JoshLongmire/Weather-Station-1-ESP32/THIRD_PARTY_LICENSES.md

# Third‑Party Licenses

Project license: PolyForm Noncommercial 1.0.0 (see `LICENSE`).
Docs and images: CC BY‑4.0 (see `LICENSE-CC-BY-4.0.md`).

This project uses the following third‑party libraries. Their original LICENSE files are kept with the libraries in your Arduino libraries directory and/or upstream repositories. Below is a summary for convenience; always refer to the original LICENSE files for the binding terms.

- Sensirion SCD4x Arduino driver (SCD40/SCD41)
  - Upstream: Sensirion AG
  - License: BSD‑3‑Clause
  - Notes: We retain license headers in any copied example code and do not remove or alter them.

- Adafruit BME680 Library
  - Upstream: Adafruit Industries
  - License: BSD

- Adafruit Unified Sensor
  - Upstream: Adafruit Industries
  - License: BSD

- Adafruit VEML7700 Library
  - Upstream: Adafruit Industries
  - License: BSD

- RTClib
  - Upstream: Adafruit/Jeelab contributors
  - License: MIT

- ArduinoJson
  - Upstream: Benoit Blanchon
  - License: MIT

- ElegantOTA
  - Upstream: Ayush Sharma
  - License: MIT

- Arduino‑ESP32 Core
  - Upstream: Espressif Systems
  - License: Apache‑2.0
