JoshLongmire/Weather-Station-1-ESP32/docs/Configsettingspage.png

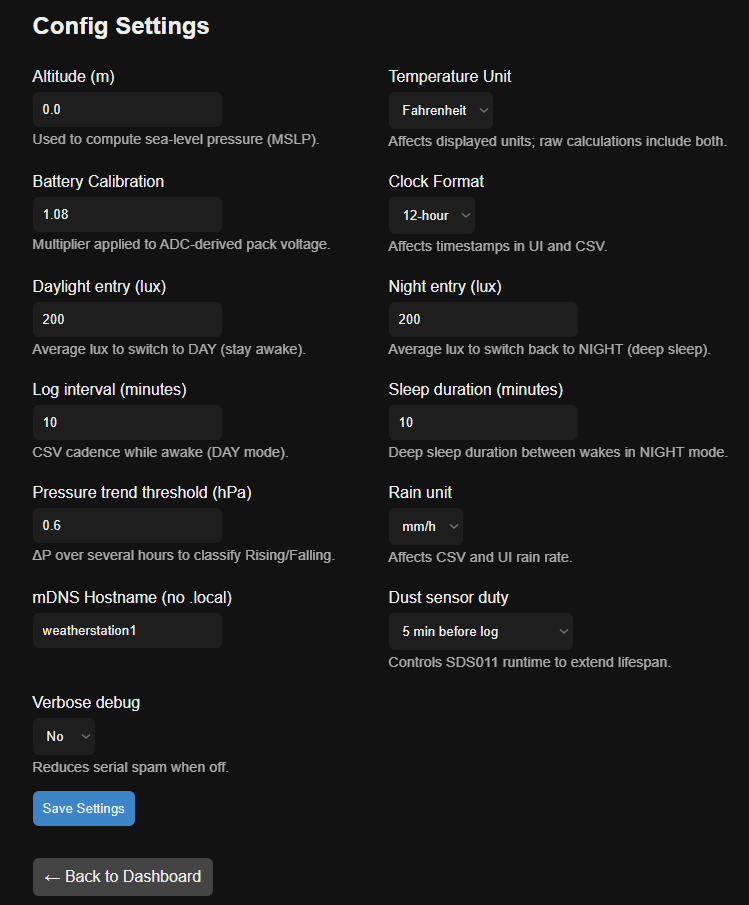
docs/Configsettingspage.png
