JoshLongmire/Weather-Station-1-ESP32/docs/Mainpage1.png

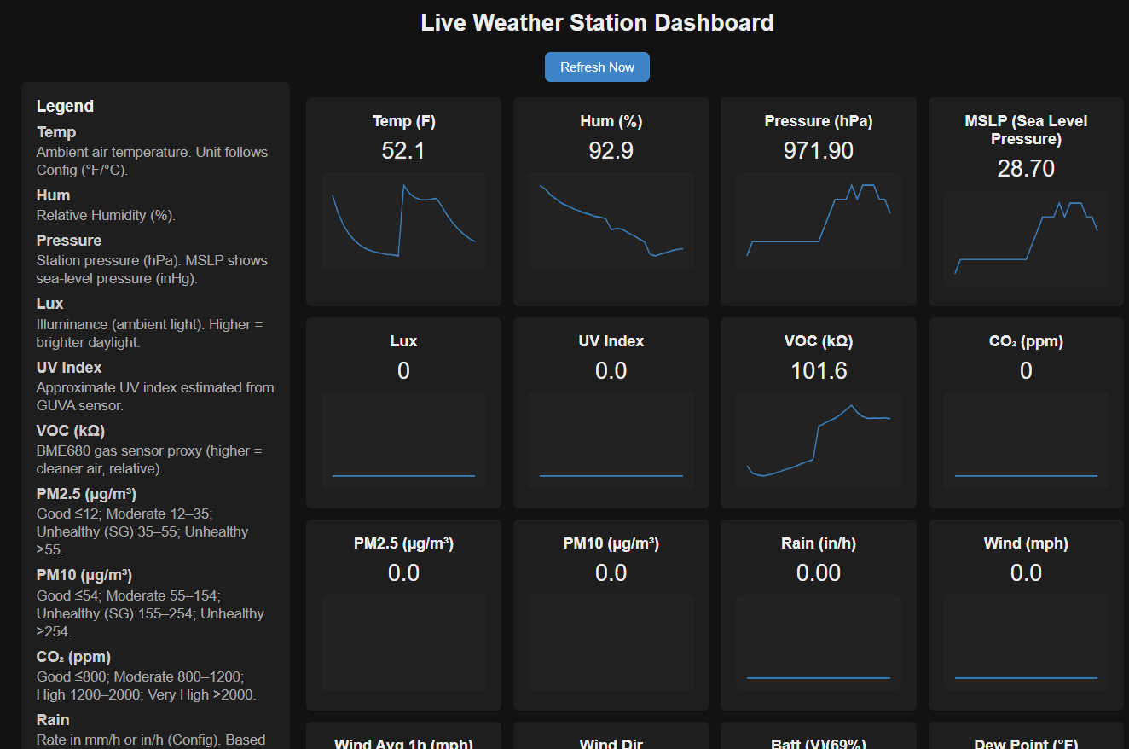
docs/Mainpage1.png
