JoshLongmire/Weather-Station-1-ESP32/docs/Mainpage2.png

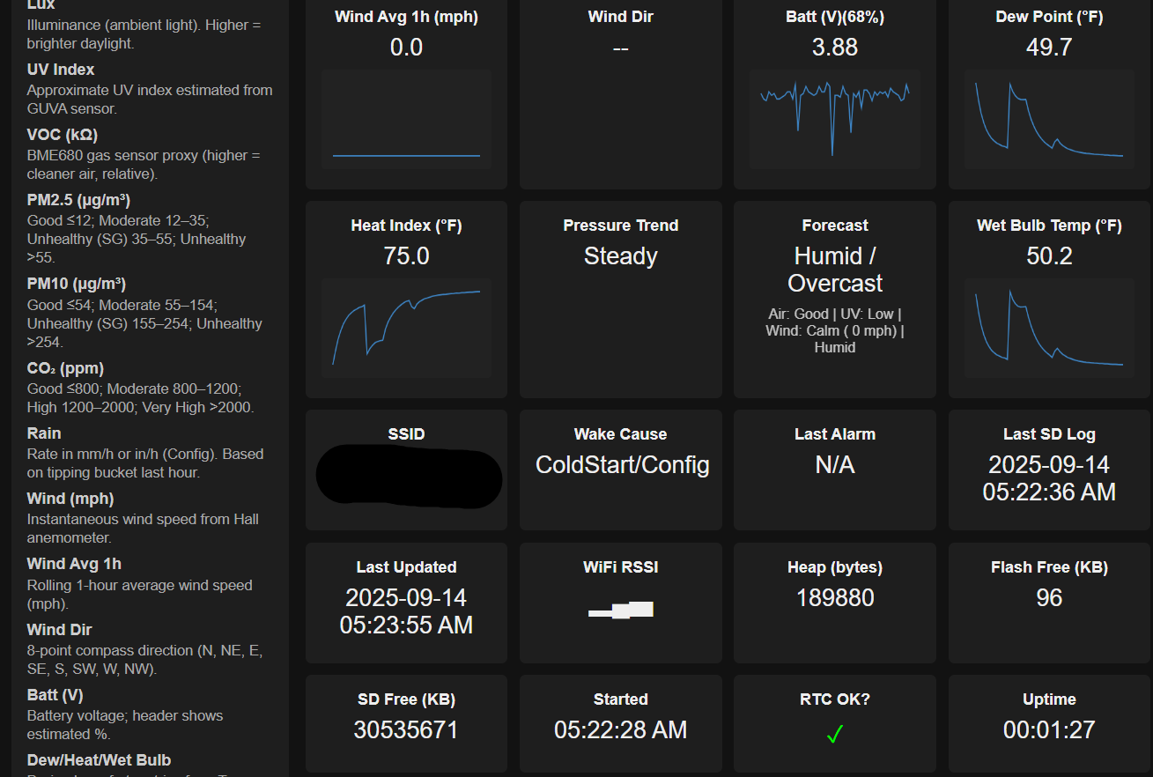
docs/Mainpage2.png
