JoshLongmire/Weather-Station-1-ESP32/docs/Mainpage3.png

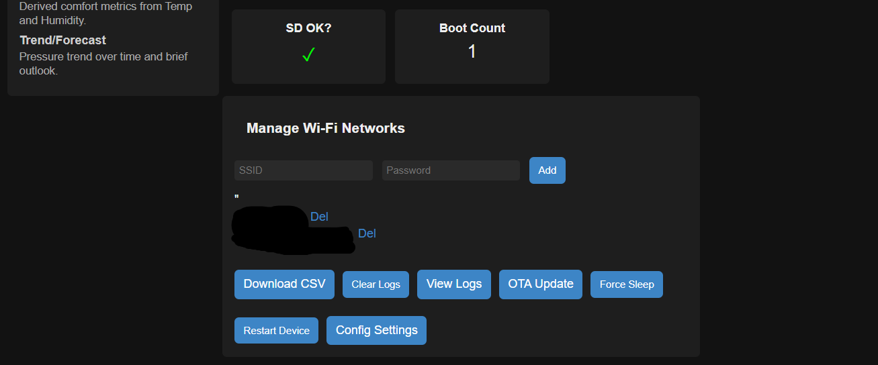
docs/Mainpage3.png
