JoshLongmire/Weather-Station-1-ESP32/docs/Mainweather0.png

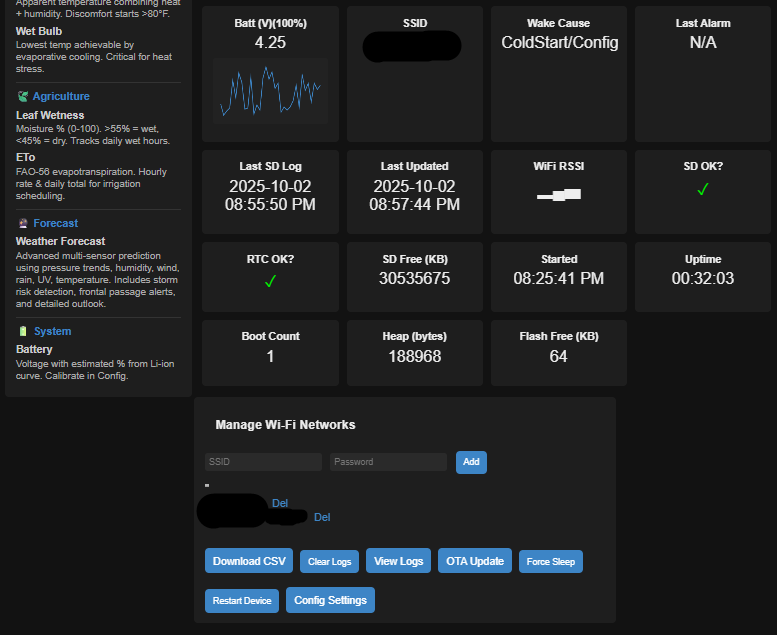
docs/Mainweather0.png
