JoshLongmire/Weather-Station-1-ESP32/docs/Mainweather1.png

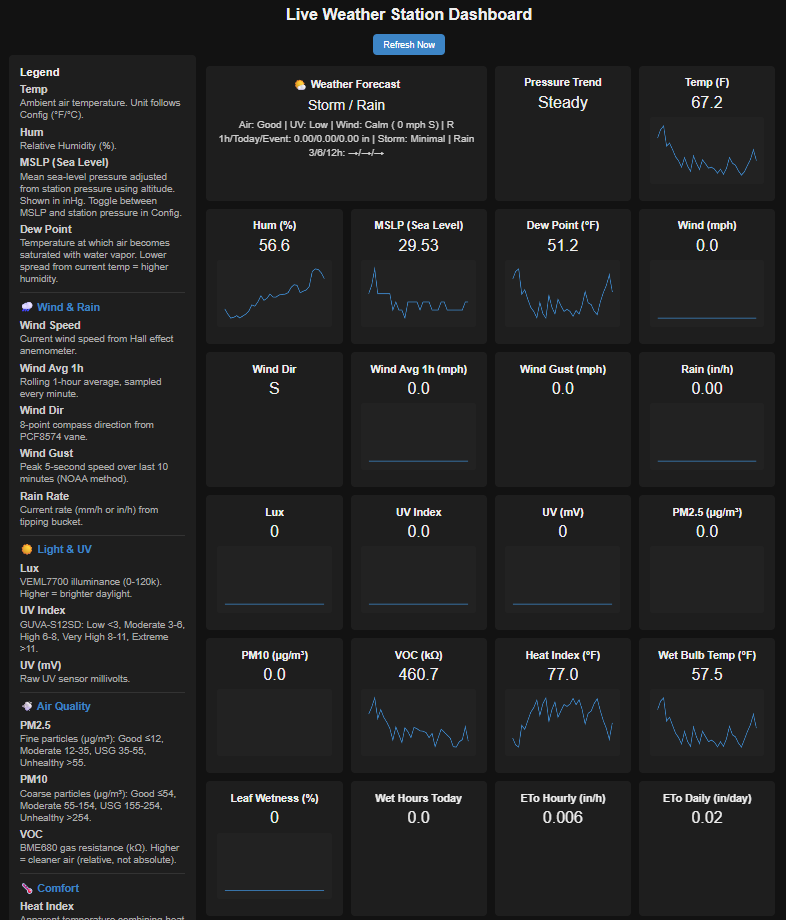
docs/Mainweather1.png
