JoshLongmire/Weather-Station-1-ESP32/docs/ViewLogspage.png

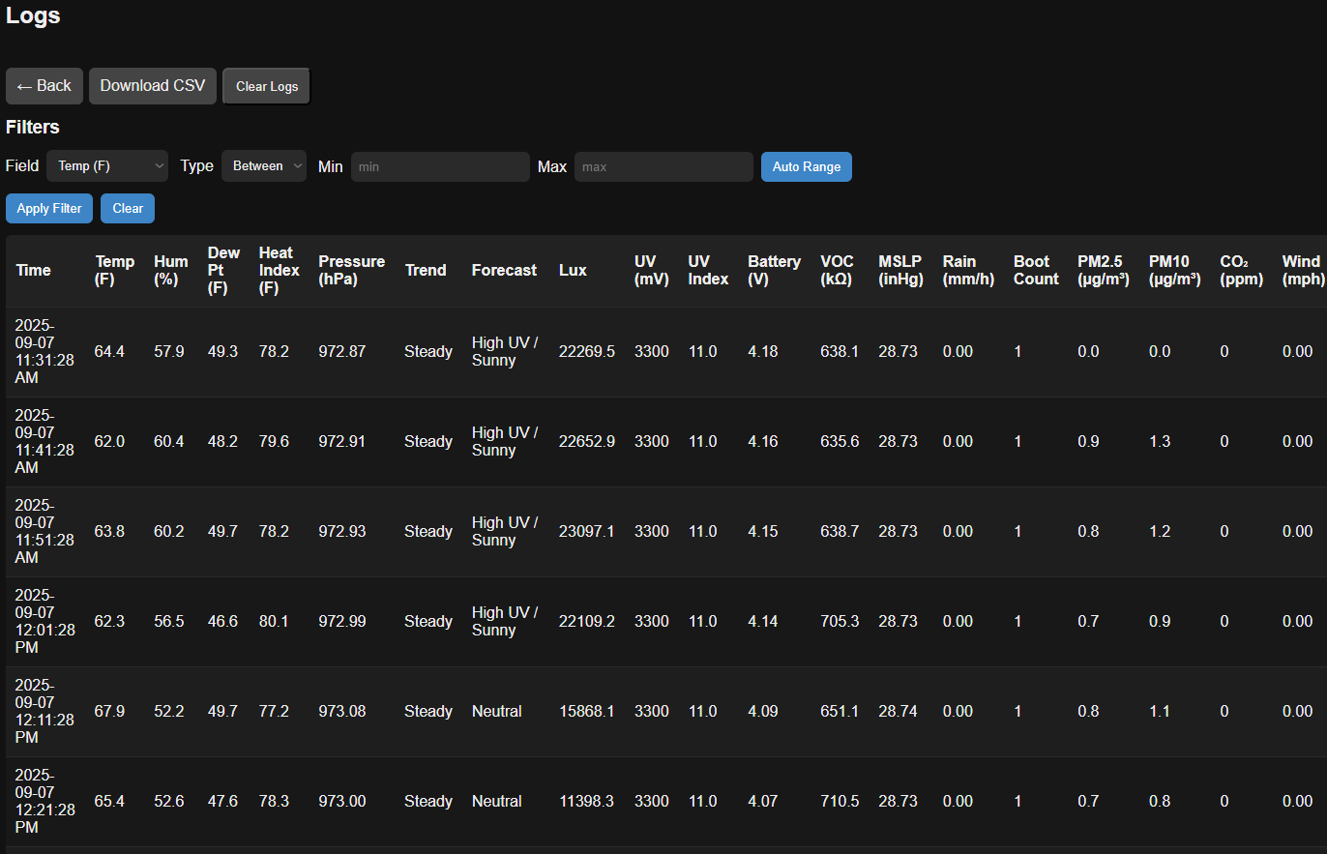
docs/ViewLogspage.png
