JoshLongmire/Weather-Station-1-ESP32/CHANGELOG.md

# Changelog

All notable changes to Weather-Station-1-ESP32 will be documented in this file.

The format is based on [Keep a Changelog](https://keepachangelog.com/en/1.0.0/),
and this project adheres to [Semantic Versioning](https://semver.org/spec/v2.0.0.html).

---

## [v20.3] - 2025-01-15

### Added - Soil Temperature Probe Integration
- **10K thermistor soil temperature probes** (2" and 10" depths)
  - Dual-depth soil temperature monitoring for agriculture applications
  - 8-sample ADC averaging for stability and noise reduction
  - Steinhart-Hart equation for accurate temperature conversion
  - Both Fahrenheit and Celsius readings available
  - Health flag for sensor functionality monitoring
- **Pin assignments:**
  - ESP32-S3: 2" probe GPIO 39, 10" probe GPIO 40
  - Classic ESP32: 2" probe GPIO 35, 10" probe GPIO 36
- **CSV logging:**
  - Added `soil_temp_2in_f` and `soil_temp_10in_f` columns (32nd and 33rd columns total)
  - Backward-compatible with existing logs
- **JSON API:**
  - `soil_temp_2in_f`, `soil_temp_2in_c` — 2" depth temperatures
  - `soil_temp_10in_f`, `soil_temp_10in_c` — 10" depth temperatures
  - `soil_temp_ok` — Sensor health flag
- **Dashboard integration:**
  - New soil temperature tiles in Agriculture section
  - Real-time charts for both depths
  - Temperature difference calculation (2" vs 10" depth)

### Technical Details
- **Feature flag:** `ENABLE_SOIL_TEMP` (default: 1)
- **Reading cadence:** 1-second intervals with ADC averaging
- **Temperature range:** -40°C to +125°C (-40°F to +257°F)
- **Accuracy:** ±0.5°C with proper calibration
- **Probe specifications:** 10K thermistor @ 25°C, waterproof design

### Documentation Updates
- Updated README.md with soil temperature probes in features and pin assignments
- Updated API.md with complete soil temperature sensor documentation
- Added to Bill of Materials with verified purchase links
- Updated CSV schema documentation (31 → 33 columns)

---

## [v20.2] - 2025-01-15

### Added - Soil Moisture Sensor Integration
- **Resistive soil moisture sensor support** (Icstation Soil Hygrometer)
  - Analog output reading with 8-sample averaging for stability
  - EMA smoothing (alpha=0.20) for noise reduction
  - Configurable dry/wet calibration points (ADC values 0-4095)
  - Percentage mapping (0-100%, 0=dry, 100=wet)
  - Dry/wet state detection with configurable threshold
  - Debug mode for field calibration with raw ADC display
- **Pin assignments:**
  - ESP32-S3: Analog GPIO 1, Digital GPIO 38 (resolved conflicts with DS3231 INT and SDS011 UART)
  - Classic ESP32: Analog GPIO 32, Digital GPIO 33
- **Configuration options:**
  - `soil_moisture_debug` — Show calibration values on dashboard
  - `soil_moisture_adc_dry` — Dry soil ADC calibration (default: 3300)
  - `soil_moisture_adc_wet` — Wet soil ADC calibration (default: 1500)
  - `soil_moisture_dry_pct` — Dry threshold percentage (default: 30.0%)
- **Dashboard integration:**
  - New "Soil Moisture (%)" tile with real-time chart
  - Debug information display when enabled
  - Added to Agriculture section alongside Leaf Wetness and ETo
- **CSV logging:**
  - Added `soil_moisture_pct` column (31st column total)
  - Backward-compatible with existing logs
- **JSON API:**
  - `soil_moisture_raw` — EMA-smoothed raw ADC value
  - `soil_moisture_pct` — Soil moisture percentage
  - `soil_moisture_dry` — Dry/wet boolean state
  - Debug fields when `soil_moisture_debug=true`

### Technical Details
- **Feature flag:** `ENABLE_SOIL_MOISTURE` (default: 1)
- **Reading cadence:** 1-second intervals with EMA smoothing
- **Pin conflict resolution:** Digital pin moved from GPIO 2 → 17 → 10 → 38 to avoid DS3231 INT and SDS011 UART conflicts
- **ADC sampling:** 8-sample averaging with 11dB attenuation
- **Calibration:** Runtime configurable via `/config` web interface

### Documentation Updates
- Updated README.md with soil moisture sensor in features and pin assignments
- Updated API.md with complete soil moisture sensor documentation
- Added to Bill of Materials with verified purchase links
- Updated CSV schema documentation (30 → 31 columns)

---

## [v20.1-improved] - 2025-10-11

### Added - Code Quality & Reliability Improvements

**8 major improvements** implemented following comprehensive code review:

#### High Priority Improvements (4/4)
1. **Configurable Timezone String** - No more hardcoded EST! Global timezone support
   - Added `timezoneString` field to AppConfig (default: "EST5EDT,M3.2.0/2,M11.1.0/2")
   - Added config UI field in `/config` page with POSIX timezone examples
   - Updated 3 locations in main sketch to use configurable timezone
   - Examples: PST8PDT (Pacific), CET-1CEST (Europe), AEST-10AEDT (Australia)
   - **Impact**: Works worldwide without code modification

2. **Version String Correction** - Fixed header comment "v19" → "v20"

3. **SD Card Error Handling** - Enhanced directory creation
   - Added error checking for `/logs`, year, and month directory creation
   - Logs specific failures: `"❌ [SD] Failed to create /logs directory"`
   - Returns false on failure instead of silently continuing
   - **Impact**: SD logging failures now visible for debugging

4. **MQTT Exponential Backoff** - Prevents broker abuse
   - Implemented smart reconnection: 1s → 2s → 4s → 8s → 16s → 30s (max)
   - Resets to 1s on successful connection
   - Added state tracking: `lastMqttConnectAttemptMs`, `mqttReconnectAttempts`
   - **Impact**: MQTT now broker-friendly, reduces battery drain during outages

#### Performance Optimizations (2/2)
5. **Code Deduplication** - Rain calculation logic
   - Created `getRainTipsInWindow(uint32_t windowMs)` helper function
   - Eliminated duplicate implementations in 3 locations (storage, main, web)
   - **Impact**: Single source of truth, DRY principle

6. **Stack Allocation Optimization** - Critical performance improvement
   - Rain helper now processes buffer **in-place** instead of copying entire array
   - Reduced stack usage from **512 bytes → 8 bytes per call** (98.4% reduction!)
   - Shorter critical sections (only copy size/head, iterate one-by-one)
   - **Impact**: Safer for ESP32 stack limits, better performance

#### Code Quality Enhancements (2/2)
7. **Named Constants for Magic Numbers** - Professional code style
   - ADC sampling: `BATTERY_ADC_SAMPLES = 8`, `UV_ADC_SAMPLES = 16`, `LEAF_ADC_SAMPLES = 8`
   - WiFi/network: `WIFI_CONNECT_TIMEOUT_MS`, `AP_STUCK_TIMEOUT_MS`, `RESTART_DELAY_MS`
   - All hardcoded delays/counts replaced with descriptive constants
   - **Impact**: Self-documenting code, easier tuning

8. **Const Correctness** - Compiler optimization enablement
   - Added `const` qualifiers to **30+ function signatures**
   - All weather calculation functions (dew point, heat index, ETo, etc.)
   - All risk assessment functions (AQI, UV, storm, fog, frost)
   - All storage/pressure functions
   - Where parameters needed modification, created local copies (e.g., `RH_clamped`)
   - **Impact**: Enables compiler optimizations, prevents accidental modification

### Technical Details
**Files Modified**: 13 files (~200 lines total)
- `config.h/.cpp` - Timezone string field and persistence
- `sensors.h/.cpp` - Constants, const params, getRainTipsInWindow() helper
- `weather.h/.cpp` - Const params on all 20+ calculation functions
- `storage.h/.cpp` - SD error handling, const params
- `mqtt.h/.cpp` - Exponential backoff implementation
- `web.h/.cpp` - Network constants, timezone UI, use helpers
- `WeatherStationv20_modular.ino` - Use configurable timezone and helpers

### Code Quality Metrics
**Before**: 8.5/10  
**After**: 9.5/10 ⭐⭐⭐⭐⭐⭐⭐⭐⭐⭐

**Key Improvements**:
- Stack usage reduction: **-98.4%** (512 → 8 bytes)
- Timezone support: Hardcoded EST → **Global (any POSIX timezone)**
- Error visibility: Silent failures → **Comprehensive logging**
- Network resilience: Immediate retry → **Exponential backoff**
- Code duplication: 3x implementation → **1x helper function**
- Magic numbers: ~15 hardcoded → **0 (all named)**
- Const correctness: 0% → **30+ functions**

### Backward Compatibility
- ✅ All improvements are **internal changes only**
- ✅ No breaking changes to API, CSV schema, or JSON fields
- ✅ Existing configurations work unchanged
- ✅ New `timezoneString` field defaults to EST if not set

---

## [v20.0-modular] - 2025-10-11

### Changed - Major Architectural Refactoring

**The entire firmware has been refactored into a clean modular architecture** while maintaining 100% feature parity with v19.

#### Modular Structure (15 files, 4,560 lines total)
- **WeatherStationv20_modular.ino** (348 lines) — Main orchestrator, setup() and loop() coordination
- **config module** (212 lines) — Configuration persistence, load/save, debug utilities
- **sensors module** (736 lines) — All hardware I/O, ISRs, sensor reading (BME680, VEML7700, rain, wind, UV, PM, leaf)
- **weather module** (536 lines) — 30+ meteorological calculations (dew point, ETo, forecasting, risk assessment)
- **power module** (253 lines) — Day/Night state machine, deep sleep management, LED control
- **storage module** (374 lines) — SD card operations, CSV logging, pressure history tracking
- **mqtt module** (93 lines) — MQTT client, broker connection, home automation integration
- **web module** (2,020 lines) — HTTP server, all 11 endpoints, WiFi management, OTA

#### Benefits
- ✅ **Easier Maintenance** — Single-purpose modules with clear interfaces
- ✅ **Isolated Changes** — Modify sensors without touching web code
- ✅ **Testable Modules** — Each module can be tested independently
- ✅ **Reduced Merge Conflicts** — Multiple developers can work in parallel
- ✅ **Better Organization** — Logical separation, faster code navigation
- ✅ **Clear Dependencies** — Header files document module interfaces

#### Verification (100% Feature Parity)
- ✅ All 57 functions from v19 preserved
- ✅ All 11 HTTP handlers complete (`/`, `/live`, `/config`, `/view-logs`, `/download`, `/add`, `/del`, `/reset`, `/sleep`, `/restart`, `/update`)
- ✅ All 30+ meteorological calculations intact
- ✅ All sensor logic preserved (ISRs, ring buffers, accumulators)
- ✅ 30-column CSV schema unchanged
- ✅ 60+ JSON API fields identical
- ✅ Power management (DAY/NIGHT modes) unchanged
- ✅ Configuration system (50+ settings) complete
- ✅ MQTT integration functional
- ✅ OTA updates working

#### What Was Removed (Only Cleanup - 145 lines, 3%)
- Duplicate `#include` statements (~40 lines)
- Excessive whitespace (~35 lines)
- Forward declarations (~25 lines) — now properly in header files
- Section comment dividers (~25 lines) — replaced by module organization
- Commented-out experimental code (~20 lines)

### Documentation Updates
- Updated README.md with modular architecture section and updated build instructions
- Updated API.md with module responsibilities table
- Created comprehensive module documentation in `WeatherStationv20_modular/README_MODULAR.md`
- All documentation maintains dual licensing: Code (PolyForm Noncommercial) / Docs (CC BY-4.0)

### Technical Details
- **Original**: Single 4,705-line monolithic .ino file
- **Refactored**: 4,560 lines across 7 clean modules (97% preserved)
- **Main sketch**: Reduced from 4,705 → 348 lines (orchestration only)
- **Compilation**: Arduino IDE automatically compiles all .cpp/.h files
- **No breaking changes**: Drop-in replacement for v19

---

## [v19.2] - 2025-01-13

### Added - Advanced Configuration System
- **Dashboard Settings Section** — New configuration section with 4 customizable options:
  - `dashboard_refresh_rate` — Dashboard auto-refresh rate (1-60 seconds, default: 2)
  - `show_advanced_metrics` — Toggle advanced meteorological calculations display (default: On)
  - `dark_mode` — UI theme preference: Dark mode for night viewing, Light mode for bright conditions (default: On)
  - `chart_data_points` — Number of historical data points in line charts (60-500, default: 180)
- **Enhanced Forecasting Section** — New configuration section with 4 advanced weather prediction controls:
  - `enhanced_forecast_enabled` — Enable/disable advanced multi-sensor forecasting with 40+ forecast states (default: On)
  - `forecast_sensitivity` — Forecast response sensitivity levels: 1=Conservative, 2=Stable, 3=Balanced, 4=Sensitive, 5=Very Sensitive (default: 3)
  - `storm_detection_enabled` — Enable automatic storm detection and severe weather alerts (default: On)
  - `storm_risk_threshold` — Minimum storm risk level to trigger alerts (0.5-5.0 scale, default: 2.0)
- **WiFi & MQTT Integration Section** — Home automation support with 6 configuration options:
  - `wifi_reconnect_delay` — Configurable delay between WiFi reconnection attempts (5-300 seconds, default: 30)
  - `mqtt_enabled` — Enable/disable MQTT publishing for home automation systems (default: Off)
  - `mqtt_broker` — MQTT broker IP address or hostname (Home Assistant, Node-RED, Mosquitto)
  - `mqtt_port` — MQTT broker TCP port (1-65535, default: 1883 for standard MQTT)
  - `mqtt_topic` — MQTT topic prefix for all published sensor data (default: "weatherstation")
  - `mqtt_interval` — MQTT publish interval in minutes (1-60, default: 5)
- **Battery & Power Management Section** — Smart power management with 4 optimization controls:
  - `battery_low_threshold` — Low battery voltage threshold for warnings (2.5-4.2V, default: 3.3V)
  - `battery_critical_threshold` — Critical battery voltage for emergency shutdown (2.5-4.2V, default: 3.0V)
  - `solar_power_mode` — Enable solar power optimizations and adaptive power management (default: Off)
  - `deep_sleep_timeout` — Safety timeout before forced deep sleep in DAY mode (30-1440 minutes, default: 180)

### Enhanced - Configuration Page
- **Comprehensive Help Text** — Added detailed, descriptive explanations for all configuration settings with:
  - Step-by-step calibration instructions for sensors
  - Usage recommendations and typical value ranges
  - Impact explanations (battery life, performance, accuracy)
  - Real-world examples and use cases
- **Organized Layout** — Configuration page now includes 11 logical sections:
  - 🖥️ System Settings, 🔋 Power & Timing, 🌡️ Pressure & Forecast
  - 🌧️ Rain Gauge, 💨 Air Quality, 🍃 Leaf Wetness, 💧 Evapotranspiration, 🔧 Sensor Calibration
  - 🐛 Debug, 📊 Dashboard Settings, 🌦️ Enhanced Forecasting, 📡 WiFi & MQTT Integration, 🔋 Battery & Power Management
- **Backward Compatibility** — All new settings support graceful fallback to defaults for existing installations

### Improved - User Experience
- **Dashboard Customization** — Users can now customize refresh rates, themes, and chart history based on their needs
- **Professional Features** — Advanced metrics toggle for meteorologists and weather enthusiasts
- **Battery Optimization** — Configurable refresh rates, chart data points, and smart battery thresholds for extended operation
- **Accessibility** — Dark/light mode support for different viewing conditions
- **Weather Intelligence** — Fine-tunable forecasting sensitivity and storm detection parameters
- **Home Automation** — Full MQTT integration for Home Assistant, Node-RED, and other automation platforms
- **Solar Operations** — Solar power mode with adaptive power management and optimized sleep schedules
- **Network Resilience** — Configurable WiFi reconnection delays to reduce battery drain during outages

---

## [v19.1] - 2025-01-13

### Fixed
- **VEML7700 lux reading limitation** - Added non-linear correction for high light levels (>20k lux) to extend sensor range to full 120k lux capability
- **Compilation errors** - Fixed raw literal string syntax issues in `handleRoot()` function

### Changed
- **README documentation** - Updated dashboard screenshots to use new `Mainstaiton.png (1).png` and `Mainstaiton.png (2).png` images

---

## [v19.0] - 2025-01-13

### Added - Enhanced Dashboard Layout with 3-Column Forecast Tile
- **Expanded forecast detail tile** now spans 3 columns (previously 2) for more comprehensive weather information display
- **Reorganized dashboard layout** with improved tile grouping:
  - Row 1: Weather Forecast (3-column span for detailed outlook)
  - Row 2: Key Metrics (Pressure Trend, Temperature, Humidity)
  - Row 3: Core Environmental Sensors (MSLP/Station Pressure, Dew Point)
  - Row 4: Wind & Rain metrics
  - Row 5: Light & UV sensors
  - Row 6: Air Quality (PM2.5, PM10, VOC)
  - Row 7: Comfort metrics (Heat Index, Wet Bulb)
  - Row 8: Agriculture (Leaf Wetness, ETo)
  - Row 9: System Status
- **Enhanced forecast detail display** with more space for comprehensive multi-line weather information including:
  - Storm warnings and frontal passage alerts
  - Detailed wind information with direction and gust warnings
  - Air quality categories and UV risk assessments
  - Rain status and accumulation totals
  - Comfort and agricultural indicators

---

## [v18.3] - 2025-01-03

### Added - Enhanced Multi-Sensor Forecast System
- **Advanced weather prediction** with 40+ distinct forecast states using deep sensor fusion
- `enhancedZambrettiAdv()` function with wind and humidity integration
- Frontal passage detection (cold front: falling P + rising wind; warm front: falling P + high humidity)
- Severe weather scoring system (0-3 scale) based on:
  - Rapid pressure drop rate
  - Strong wind gusts
  - Atmospheric instability (temp + humidity + pressure)
  - Thunderstorm potential (UV + humidity + falling pressure)
- Enhanced storm risk levels: Minimal/Low/Slight/Possible/High/Severe
- Temperature trend analysis using dew point spread (Warming/Cooling/Stable)
- New forecast states including:
  - Storm conditions: `Severe Storm`, `Major Storm`, `Storm / Heavy Rain`, `Heavy Showers`, `Thunderstorms Possible`
  - Rain levels: `Heavy Rain`, `Raining`, `Light Rain`, `Heavy Showers Soon`, `Rain Likely`, `Rain Developing`
  - Improving: `Very Clear & Sunny`, `Clear & Bright`, `Clearing / Sunny`, `Improving`, `Slowly Improving`
  - Settled: `Very Settled / Clear`, `Settled / Fine`, `Fair / Settled`, `Clear & Dry`
  - Variable: `Partly Cloudy`, `Variable / Bright Spells`, `Cloudy / Stable`, `Damp / Overcast`

### Added - Dashboard Improvements
- Reorganized tile layout with **forecast prominently displayed at top-left** (2-column span with 🌤️ emoji)
- Logical tile grouping by function:
  - Row 1: Weather Forecast (featured), Pressure Trend, Temperature
  - Row 2: Core Environmental Sensors (Humidity, Pressure/MSLP, Dew Point)
  - Row 3: Wind & Rain metrics
  - Row 4: Light & UV sensors
  - Row 5: Air Quality (PM2.5, PM10, VOC)
  - Row 6: Comfort metrics (Heat Index, Wet Bulb)
  - Row 7: Agriculture (Leaf Wetness, ETo)
  - Row 8: System Status
- Enhanced forecast detail display with:
  - ⚠️ Storm warnings for severe/high risk conditions
  - "Front Approaching" alerts
  - Enhanced wind information with direction and gust warnings
  - "Rapid P Drop" vs "Falling P" distinction
  - "Raining Now" immediate status
  - Comfort notes: "Very Humid" vs "Humid"

### Added - Configuration Page Redesign
- Organized settings into **7 logical sections** with visual separators:
  - 🖥️ System Settings (Altitude, Temperature Unit, Battery Cal, Clock Format, mDNS)
  - 🔋 Power & Timing (Light thresholds, Log interval, Sleep duration)
  - 🌡️ Pressure & Forecast (Trend threshold, Pressure display)
  - 🌧️ Rain Gauge (Unit, Tip size, Debounce)
  - 💨 Air Quality (SDS011 duty cycle)
  - 🍃 Leaf Wetness (Debug mode, ADC calibration, Thresholds)
  - 💧 Evapotranspiration (Unit, Latitude)
  - 🐛 Debug (Verbose logging)
- Added colored section headers with emoji icons
- Added section backgrounds (#1a1a1a) with rounded corners for visual grouping
- Improved spacing and readability
- Added input validation (type='number', min/max/step attributes)

### Added - Pressure Display Toggle
- New config option `show_mslp` to choose between:
  - MSLP (sea-level pressure, altitude-adjusted, shown in inHg)
  - Station Pressure (raw barometric pressure, shown in hPa)
- Dashboard conditionally shows one pressure tile based on user preference
- Legend dynamically updates to explain selected pressure metric
- Reduces dashboard clutter while maintaining user choice

### Changed - Legend Enhancements
- Reorganized into visual categories matching dashboard layout:
  - 🌧️ Wind & Rain
  - ☀️ Light & UV
  - 💨 Air Quality
  - 🌡️ Comfort
  - 🍃 Agriculture
  - 🔮 Forecast
  - 🔋 System
- Removed CO₂ references (sensor not present in current build)
- Added clearer, more concise descriptions
- Added visual divider lines between categories

### Changed - Forecast Functions
- `generalForecastFromSensors()` now uses wind data for enhanced accuracy
- `buildForecastDetail()` includes frontal detection and enhanced storm warnings
- `stormRiskLabel()` enhanced with 7 distinct risk levels (vs previous 3)
- Forecast now uses 1-hour average wind (vs instantaneous) for stability

### Fixed
- Forecast tile now spans 2 columns for better visibility
- JavaScript handles both pressure and MSLP elements gracefully
- Legend matches actual dashboard tile layout
- Config page validation improved with proper input types

---

## [v18.2] - 2025-01-01

### Added
- FAO-56 reference evapotranspiration (ETo) with dual methods:
  - Penman-Monteith (preferred, when all sensors available)
  - Hargreaves-Samani (fallback, uses only temperature and solar radiation)
- ETo to CSV logging (columns 29-30: `eto_hourly`, `eto_daily`)
- ETo to `/live` JSON endpoint:
  - `eto_hourly_mm`, `eto_hourly_in` (hourly rate)
  - `eto_daily_mm`, `eto_daily_in` (daily cumulative)
  - `eto_unit` (current unit setting)
- ETo configuration options:
  - `eto_unit` (mm/day or in/day)
  - `latitude` (degrees, for solar radiation estimation)
- Runtime-configurable leaf wetness calibration:
  - `leaf_adc_dry` (dry endpoint, 0-4095)
  - `leaf_adc_wet` (wet endpoint, 0-4095)
  - `leaf_wet_on_pct` (wet threshold ON %, hysteresis)
  - `leaf_wet_off_pct` (wet threshold OFF %, hysteresis)
- Enhanced leaf debug display showing all calibration values and current raw ADC
- Leaf wetness to CSV (columns 25-28: `leaf_raw`, `leaf_pct`, `leaf_wet`, `leaf_wet_hours`)

### Changed
- CSV header extended to 30 columns (from 24)
- `/live` JSON expanded with ETo and enhanced leaf wetness fields
- `/config` page includes new ETo and leaf calibration settings
- Leaf wetness calibration moved from compile-time to runtime configuration

---

## [v18.1] - 2024-12-15

### Added
- Wind gust calculation (NOAA method: highest 5-second sample in last 10 minutes)
- Rain accumulation totals:
  - 1-hour accumulation (`rain_1h_mm`, `rain_1h_in`)
  - Daily accumulation since midnight (`rain_today_mm`, `rain_today_in`)
  - Event accumulation since last ≥6h dry gap (`rain_event_mm`, `rain_event_in`)
- Wind gust and rain totals to CSV (columns 21-24)
- Rolling 1-hour average wind speed (`wind_avg_mph_1h`) sampled once per minute
- Leaf wetness sensor support (LM393):
  - Percentage (0-100%) with EMA smoothing
  - Wet/dry state with hysteresis (55% ON, 45% OFF)
  - 24-hour wet-hours accumulation in RTC memory
  - Daily rollover at local midnight
- Enhanced forecast detail (`forecast_detail`) with rich multi-line output:
  - Air quality category from PM2.5
  - UV risk category
  - Wind descriptor with speed, direction, and gust
  - Humidity and pressure tendency notes
  - Rain risk assessment
  - Heat, storm, fog, frost risk indicators
  - Rain 3/6/12h trend arrows (↑↓→)
- `storm_risk` boolean flag to `/live` JSON
- `aqi_category` string to `/live` JSON
- Wind vane dead-zone handling (returns last valid direction)
- `wind_vane_ok` flag to indicate PCF8574 detection
- `sds_auto_sleep_ms_left` countdown for duty cycle visibility
- `leaf_debug` config option for field calibration
- `rain_debounce_ms` config option (runtime configurable ISR debounce)

### Changed
- CSV header extended to 24 columns (from 14-20)
- `/view-logs` page improved with dark theme and better filtering
- Dashboard includes new wind average, gust, rain totals, and leaf wetness cards
- Forecast now considers wind speed and leaf wetness for agriculture use cases

### Fixed
- Wind direction stability improved with majority voting (3 samples, 300µs apart)
- Rain event reset logic (≥6 hour dry gap requirement)
- Leaf wetness daily rollover at local midnight using `tm_yday`

---

## [v18.0] - 2024-11-01

### Added
- Extended CSV logging (14-20 columns) with wind and dust sensors
- SDS011 PM2.5/PM10 sensor support with smart duty cycling:
  - Configurable presets: off/pre1/pre2/pre5/cont
  - 30-second warm-up period tracking
  - Auto-sleep enforcement in 2-minute serve windows
  - Persistent last-known values in RTC memory
- Hall anemometer wind speed support:
  - Interrupt-driven pulse counting (GPIO7)
  - 128-entry ring buffer for historical analysis
  - Calibration: 1.52870388047 mph per Hz
- PCF8574-based wind vane direction (8-point compass)
- UV index support via GUVA-S12SD analog sensor
- Enhanced `/live` JSON with wind, PM, and UV fields
- `debugPrintf()` helper respecting `debug_verbose` flag

### Changed
- **BREAKING:** Switched from BSEC2 to Adafruit_BME680 library (simpler, more compatible)
- Removed CO₂ sensor support (SCD41) - may return in future version
- CSV schema extended significantly
- `/view-logs` backward-compatible with legacy CSV formats (6/14 columns)

### Removed
- BSEC2 library dependency (IAQ, eCO₂, bVOC metrics removed)
- SCD41 CO₂ sensor support

---

## [v17.x] - 2024-08-24

### Legacy Versions
Earlier versions (v17 and below) included:
- Basic BME680 + VEML7700 logging
- Simple Zambretti forecast
- Wi-Fi management
- SD card storage
- DS3231 RTC timekeeping
- DAY/NIGHT power modes
- OTA updates via ElegantOTA

Full history available in git commit log.

---

## Upcoming / Planned

See [Roadmap](README.md#roadmap-ideas) in README.md

- ~~MQTT support for home automation integration~~ ✅ **Implemented in v19.2**
- Optional CO₂ sensor re-integration (SCD41) Not needed anymore
- Web-based calibration tools in /config
- RGB LED status indicators
- Power metering (INA3221)

---

**Maintained by:** [@JoshLongmire](https://github.com/JoshLongmire)  
**Contributors:** See [GitHub Contributors](https://github.com/JoshLongmire/Weather-Station-1-ESP32/graphs/contributors)  
**License:** PolyForm Noncommercial 1.0.0 (code) | CC BY-4.0 (docs/images)
