JoshLongmire/Weather-Station-1-ESP32/(commit log)

2025-08-22 File organization
    File so I could be open and Arduino IDE without giving an error
    Added filters to the view logs so you can filter between the maximum and the minimum of a selected field
    [WaetherStation08_22_25v17.ino]
2025-08-22 Add comprehensive API documentation for ESP32 weather station (#1)
2025-08-22 Added a new general forecast derived from sensors and surfaced it end-to-end.
    UI
    Added a new dashboard tile labeled “Forecast” right after “Pressure Trend.”
    Client JS now sets forecastVal from o.general_forecast.
2025-08-23 make it where i log from muliple senosors lol
    120k lux availability
    make it where i can log the forecast predictions Simple general forecast derived from multiple sensors.
2025-08-23 Update WaetherStation08_22_25v17.ino
    What I changed
    CSV order (finalized):
    timestamp,temp_f,humidity,dew_f,hi_f,pressure,pressure_trend,forecast,lux,voltage,voc_kohm,boot_count
    Logging rows:
    Now write forecast immediately after pressure_trend.
    Reset header:
    /reset recreates logs.csv with the new header above.
    Boot row:
    Emits an empty row matching the new order with only boot_count populated.
    View Logs page:
    Columns reordered to match: Forecast is displayed after Trend.
    Old six-column lines still render gracefully with blanks.
    Field selector indices updated to reflect the new positions.
    URL filter mapping updated (e.g., field=forecast maps correctly).
    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
    [WaetherStation08_22_25v17.ino]
2025-08-24 Too much added, but needed
    What to expect:
    The “boot count only” rows should disappear; all rows line up with the header columns.
    If you still see a stray line, it’s probably the CSV header or a malformed line; the code already skips empty lines and retains the header only once.
    Fixes implemented:
    Unified CSV output in handleLive() to match performLogging() exactly: it now writes 14 columns in this order:
    timestamp,temp_f,humidity,dew_f,hi_f,pressure,pressure_trend,forecast,lux,voltage,voc_kohm,mslp_inHg,rain,boot_count
    Included proper MSLP and Rain computation in that write path, plus the same “general forecast” string.
    Updated /reset header to the same 14-column schema so new fi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
    [WaetherStation08_22_25v17.ino]
2025-08-24 Updated the read.md and docs/API.md
    Changes made:
    docs/API.md
    Set unified CSV header: timestamp,temp_f,humidity,dew_f,hi_f,pressure,pressure_trend,forecast,lux,voltage,voc_kohm,mslp_inHg,rain,boot_count.
    Updated example row and notes for units, forecast, and rain units.
    Documented /view-logs field list and Auto Range.
    /config now lists rain_unit; removed obsolete pressure_unit note in this context.
    Clarified sketch filename reference.
    README.md
    Fixed repo layout path to docs/API.md.
    Marked /live JSON as “selected fields” and included new fields (wbt_f, mslp_*, forecast, rain_mmph).
    Config section adds rain_unit.
    I also cancelled the requested todo “Make View Logs tolerant of 11-col leg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
2025-08-24 Update
    Added AP defaults: SSID WeatherStation1, password 12345678.
    Extended endpoints table with /sleep and /restart.
    Rewrote the /live example JSON to include temp_unit, temp_f/temp_c, dew_c/hi_c/wbt_c, rain_inph, rain_unit, general_forecast, last_sd_log, flash_free_kb, boot_started, wake details.
    Expanded the /live JSON example with the new fields above; removed outdated pressure_unit note.
    Updated Units section to reflect both °F/°C and both MSLP units; clarified rain fields and unit flag.
    Expanded GET /config fields to include lux thresholds, log interval, sleep duration, pressure trend threshold, and rain unit.
    Updated POST /config example form fields: added led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
2025-08-24 new rules added to further the dev,
    Added: project-structure.mdc — overview of key files and where major functions live; what to update together when changing CSV/API.
    Added: arduino-style.mdc — coding style and safety rules for Arduino/ESP32, JSON/CSV contracts, power/time handling.
    Added: endpoints-and-schema.mdc — stable HTTP API and CSV schema guidance; exact header/order; dashboard/docs sync rules.
    Added: arduino-ide-setup.mdc — Arduino IDE 2.3.6 build notes, required libs, board/serial settings, OTA/AP pointers.
    You can open these at .cursor/rules/*.mdc to tweak defaults like mDNS/OTA/AP names to your device.
    Changes:
    New rules in .cursor/rules to guide edits, enforce API/CSV c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
2025-08-30 Need help with adding the BSEC2 lib to work like addin the files to the complied code.
    Go to Config Settings.
    Edit “mDNS Hostname (no .local)” and Save.
    Access the device at yourname.local.
    Allowed chars: a–z, 0–9, dash. Spaces/underscores become dashes; trimmed, lowercased, max 31 chars.
    If empty/invalid, it falls back to weatherstation1.
    Completed: added mdnsHost to AppConfig, persisted in preferences, UI GET/POST support, sanitizeMdnsHost(), setup uses MDNS.begin(appCfg.mdnsHost), live restart in POST handler.
2025-09-01 Removed the bsec2 file till i can get it working, add wind speed and SDS011 sensors
    I will update the API.md and the Readme.md Later,
2025-09-01 Updated API/README
    New boards
    New Sensors
2025-09-14 Added Photos of Tripod Weather Station
    update the legend to include the new wind sensors
2025-09-14 Currently in development
    Currently in development
2025-09-21 Update documentation images and README layout
    Added new sensor and station photos, removed outdated images, and updated README to improve visual presentation and attribution. This enhances clarity and provides up-to-date visuals for the weather station project.
2025-09-21 Remove SDS011 Dust Sensor image from README
    Deleted the SDS011 Dust Sensor image from the README's image gallery section to streamline the documentation visuals.
2025-09-21 Update image layout and add SDS011 sensor photo
    Reorganized the README image gallery for improved layout, adjusted image widths, and added a new photo of the SDS011 Dust Sensor.
2025-09-30 Update docs for wind gust and rain accumulation metrics
    README.md and API.md updated to reflect new wind gust and rain accumulation fields in the CSV log and live API. CO₂ sensor references and related columns removed from documentation. Added details for new rain gauge and wind gust metrics, including configuration options and UI support.
2025-10-01 Update docs for new sensors, features, and API details
    Expanded README and API documentation to cover new hardware support (leaf wetness sensor, wind vane, SDS011), advanced features (rain accumulation, wind gusts, forecast details), updated CSV schema, and detailed API endpoint descriptions. Clarified configuration options, persistent storage, and provided comprehensive field mappings and usage examples for all endpoints.
2025-10-03 Enhance forecast, dashboard, and config with ETo and advanced features
    Added enhanced multi-sensor forecast system with 40+ states, storm and frontal detection, and severe weather scoring. Integrated FAO-56 reference evapotranspiration (ETo) with Penman-Monteith and Hargreaves-Samani methods, including new CSV columns and API fields. Reorganized dashboard and configuration page with logical sections, added pressure display toggle (MSLP/station), and improved documentation throughout README and API docs.
2025-10-03 Fix image path case in README
    Updated the image source path in the README from 'docs/ViewLogspage.png' to 'docs/view-logspage.png' to match the correct file name casing.
2025-10-03 Add CHANGELOG and update README with badges and BOM
    Introduced a detailed CHANGELOG.md documenting all notable changes and version history. Updated README.md to include project badges, a comprehensive bill of materials, a table of contents, and references to the changelog, improving project documentation and onboarding for new users.
2025-10-03 Update changelog and README with feature changes
    Clarified that SCD41 CO₂ sensor re-integration is no longer needed, specified location of web-based calibration tools, and updated optional module list in README to include soil temperature and resistance values.
2025-10-07 Add advanced configuration and MQTT integration
    Introduces a comprehensive configuration system with new sections for dashboard customization, enhanced forecasting, WiFi & MQTT integration, and battery/power management. Updates documentation and changelog to reflect new settings, features, and verified hardware links, including full MQTT support for home automation platforms.
2025-10-07 Add new sensor modules to hardware list
    Added LM393 Rain Drops Sensor, KOFU/OKI Reed Switches, and DS3231 RTC Module to the hardware lists in README.md and docs/API.md for improved documentation and reference.
2025-10-11 Refactor firmware to modular architecture (v20.0)
    Major architectural refactoring: firmware split into seven modules for configuration, sensors, weather calculations, power management, storage, MQTT, and web server. README and CHANGELOG updated to document new structure, build instructions, and verification of 100% feature parity with previous version.
2025-10-14 Add soil moisture and temperature sensor documentation
    Updated CHANGELOG.md, README.md, and API.md to document new support for resistive soil moisture sensors and dual-depth 10K thermistor soil temperature probes. Changes include feature descriptions, pin assignments, CSV schema updates, API fields, configuration options, and Bill of Materials additions for both sensor types.
