JoshLongmire/Weather-Station-1-ESP32/docs/VEML7700_UVSensors1.jpg

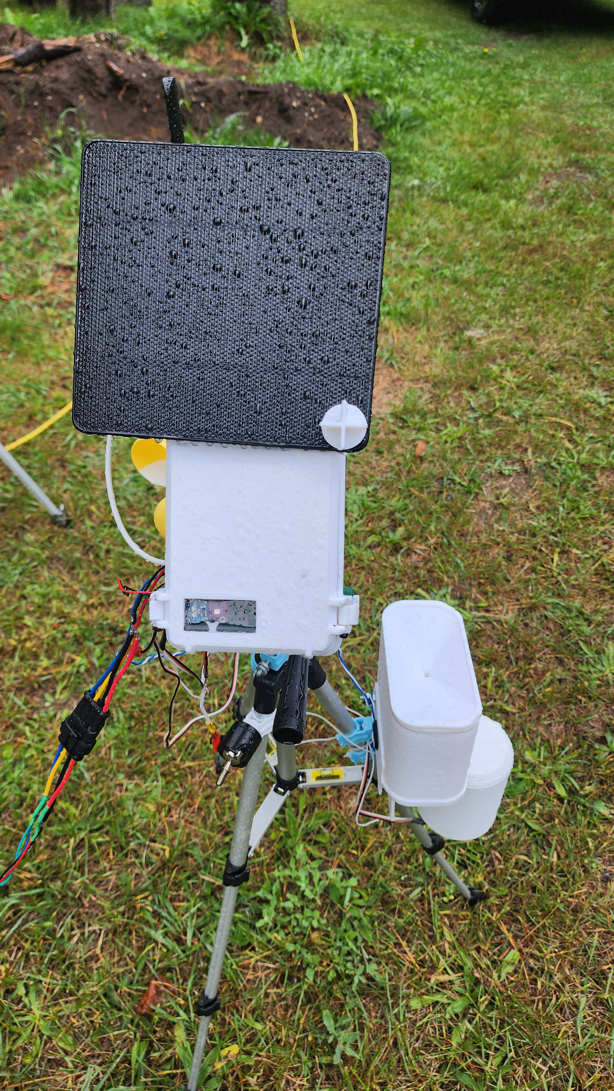
[picture p3: docs/VEML7700_UVSensors1.jpg]
docs/VEML7700_UVSensors1.jpg
